taylorinalaska/TeensyPoly6-T4.1/photos/synthlabeled.jpg

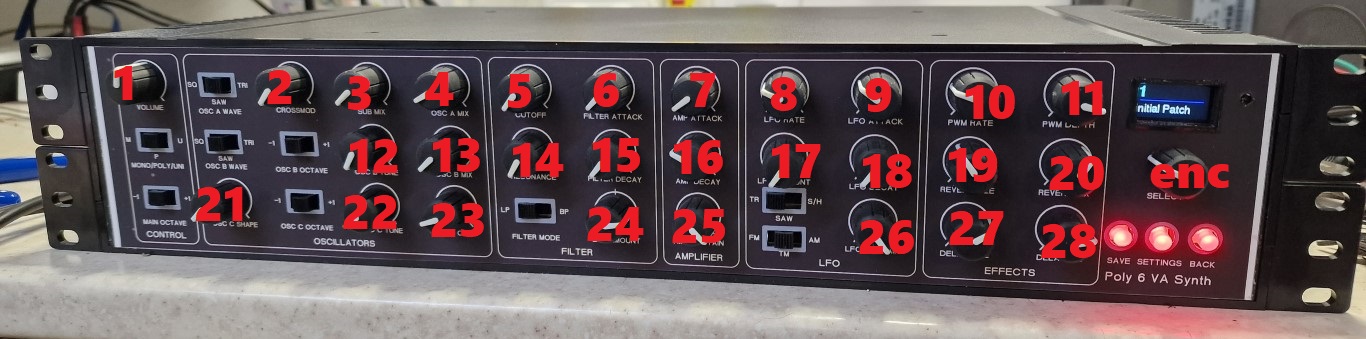
photos/synthlabeled.jpg
