taylorinalaska/TeensyPoly6-T4.1/TeensyPoly6_schematic41.pdf

1

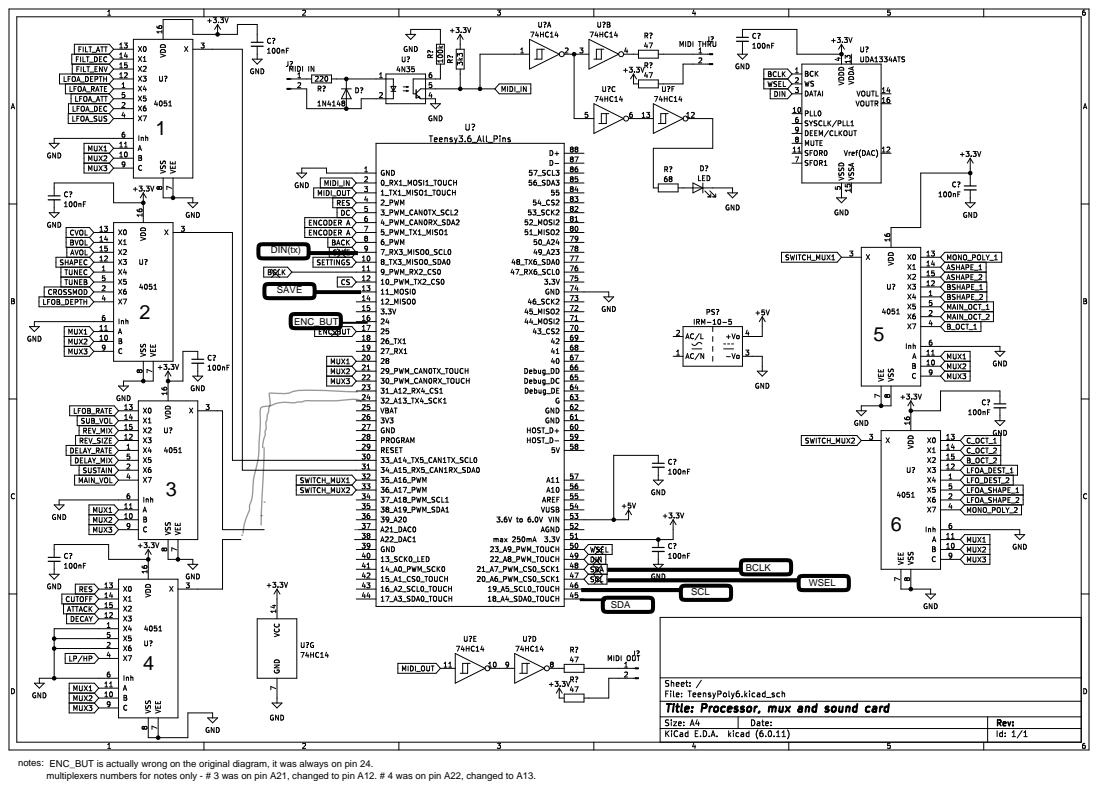
[picture p3: page 1]
ENC_BUT; SDA; SCL; BCLK; SAVE; DIN(tx); WSEL

notes: ENC_BUT is actually wrong on the original diagram, it was always on pin 24.
multiplexers numbers for notes only - # 3 was on pin A21, changed to pin A12. # 4 was on pin A22, changed to A13.
