taylorinalaska/TeensyPoly6-T4.1/tempschematic.pdf

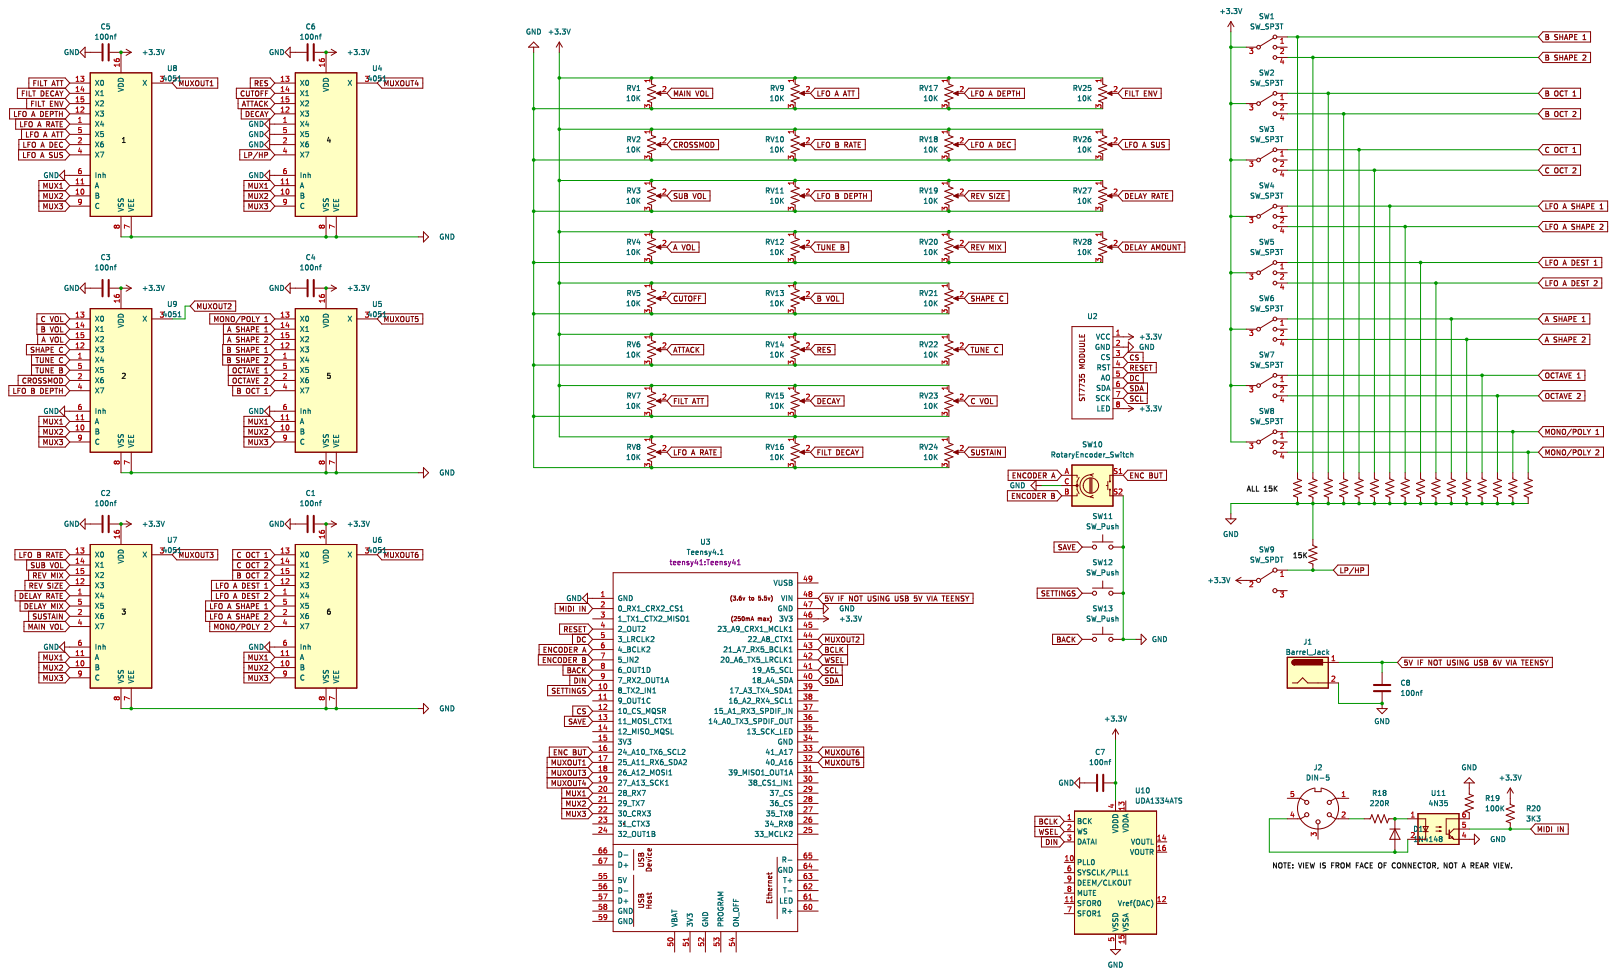
[picture p4: page 1]
