taylorinalaska/TeensyPoly6-T4.1/TeensyPoly6-frontpanel_schematic.pdf

7

16

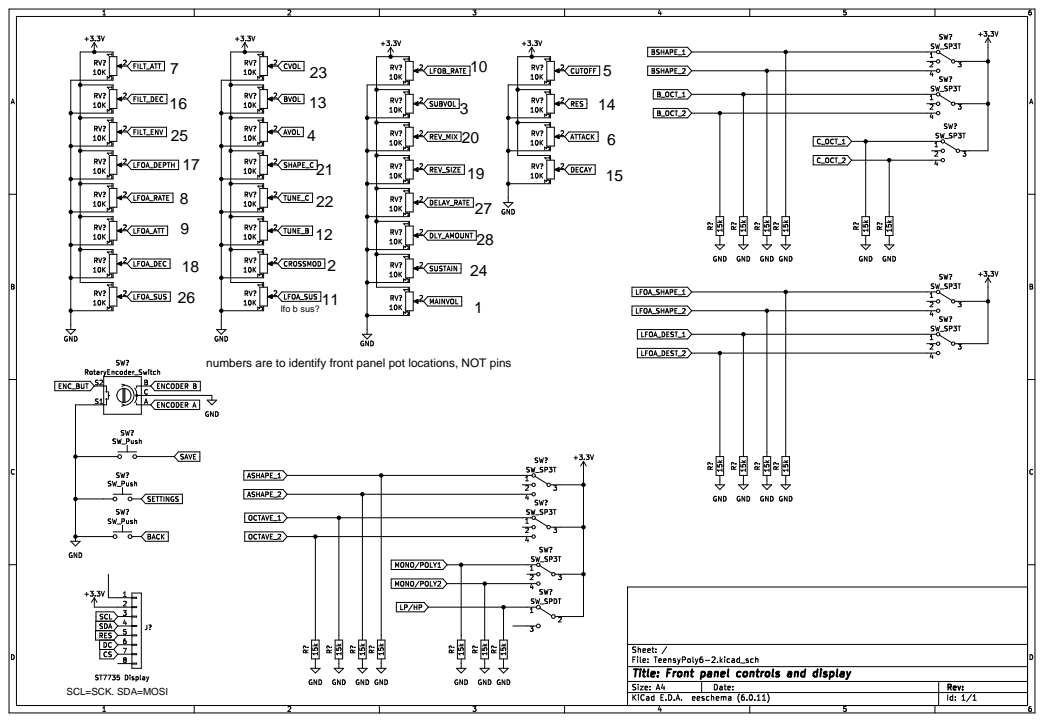
[picture p5: page 1]
lfo b sus?

numbers are to identify front panel pot locations, NOT pins

SCL=SCK. SDA=MOSI
