taylorinalaska/TeensyPoly6-T4.1/TeensyPoly6/Parameters.h

//Values below are just for initialising and will be changed when synth is initialised to current panel controls & EEPROM settings
byte midiChannel = 1;

byte pitchBendRange;
byte modWheelDepth;
byte afterTouchDepth;
byte NP;

byte ccChannel = midiChannel;
byte midiOutCh = midiChannel;
boolean patchRecall = false;

const int muxPots1 = A11;       //25
const int muxPots2 = A8;       //22
const int muxPots3 = A12;     //26    //WAS A21, 4.1 DOESNT HAVE THIS PIN
const int muxPots4 = A13;    //27    //WAS A22, 4.1 DOESNT HAVE THIS PIN
const int muxPots5 = A16;   //40
const int muxPots6 = A17;  //41

#define TOLERANCE 3

int MIDIThru = midi::Thru::Off;  //(EEPROM)
String patchName = INITPATCHNAME;
boolean encCW = true;  //This is to set the encoder to increment when turned CW - Settings Option

int midiModAmount = 0;
int returnvalue = 0;

boolean pickUp = true;  //settings option (EEPROM)
boolean pickUpActive = false;
boolean modAmount = false;
boolean saveMagicPatch = false;
boolean addingPatch = false;
boolean oldpickUpActive;
boolean Program = false;


// GUItool: begin automatically generated code
AudioSynthWaveform lfoA1;           //xy=153.9333610534668,214.64774894714355
AudioSynthWaveform lfoA2;           //xy=159.33330154418945,472.5476875305176
AudioSynthWaveform lfoA3;           //xy=161.90474319458008,732.6191596984863
AudioSynthWaveform lfoA4;           //xy=161.90474319458008,992.7619819641113
AudioSynthWaveform lfoA5;           //xy=167.30468368530273,1242.6619205474854
AudioSynthWaveform lfoA6;           //xy=169.87612533569336,1512.733392715454
AudioEffectEnvelope lfoAenv1;       //xy=232.33330917358398,129.3143424987793
AudioSynthWaveform lfoB1;           //xy=278.9333305358887,173.93335914611816
AudioEffectEnvelope lfoAenv2;       //xy=279.3332748413086,472.5476369857788
AudioEffectEnvelope lfoAenv3;       //xy=281.9047164916992,732.6191091537476
AudioEffectEnvelope lfoAenv4;       //xy=281.9047164916992,992.7619314193726
AudioSynthWaveform lfoB2;           //xy=284.3332710266113,431.8332977294922
AudioSynthWaveform lfoB3;           //xy=286.90471267700195,691.9047698974609
AudioSynthWaveform lfoB4;           //xy=286.90471267700195,952.0475921630859
AudioEffectEnvelope lfoAenv5;       //xy=287.3046569824219,1242.6618700027466
AudioEffectEnvelope lfoAenv6;       //xy=289.8760986328125,1512.7333421707153
AudioSynthWaveform lfoB5;           //xy=292.3046531677246,1201.94753074646
AudioSynthWaveform lfoB6;           //xy=294.87609481811523,1472.0190029144287
AudioMixer4 modMix1;                //xy=315.8000030517578,97.93336296081543
AudioAnalyzeRMS lfoAread1;          //xy=320.53334045410156,248.9333620071411
AudioMixer4 modMix2;                //xy=321.19994354248047,355.83330154418945
AudioMixer4 modMix3;                //xy=323.7713851928711,615.9047737121582
AudioMixer4 modMix4;                //xy=323.7713851928711,876.0475959777832
AudioMixer4 modMix5;                //xy=329.17132568359375,1125.9475345611572
AudioMixer4 modMix6;                //xy=331.7427673339844,1396.019006729126
AudioSynthWaveformModulated sub1;   //xy=470.93334197998047,208.93334197998047
AudioSynthWaveformModulated vcoA1;  //xy=471.93334197998047,115.9333381652832
AudioSynthWaveformModulated vcoB1;  //xy=471.93334197998047,146.93334770202637
AudioSynthWaveformModulated vcoC1;  //xy=471.9333724975586,177.93337440490723
AudioSynthWaveformModulated sub2;   //xy=476.3332824707031,466.8332805633545
AudioSynthWaveformModulated vcoA2;  //xy=477.3332824707031,373.8332767486572
AudioSynthWaveformModulated vcoB2;  //xy=477.3332824707031,404.8332862854004
AudioSynthWaveformModulated vcoC2;  //xy=477.33331298828125,435.83331298828125
AudioSynthWaveformModulated sub3;   //xy=478.90472412109375,726.9047527313232
AudioSynthWaveformModulated vcoA3;  //xy=479.90472412109375,633.904748916626
AudioSynthWaveformModulated vcoB3;  //xy=479.90472412109375,664.9047584533691
AudioSynthWaveformModulated vcoC3;  //xy=479.9047546386719,695.90478515625
AudioSynthWaveformModulated sub4;   //xy=478.90472412109375,987.0475749969482
AudioSynthWaveformModulated vcoA4;  //xy=479.90472412109375,894.047571182251
AudioSynthWaveformModulated vcoB4;  //xy=479.90472412109375,925.0475807189941
AudioSynthWaveformModulated vcoC4;  //xy=479.9047546386719,956.047607421875
AudioSynthWaveformModulated sub5;   //xy=484.3046646118164,1236.9475135803223
AudioSynthWaveformModulated vcoA5;  //xy=485.3046646118164,1143.947509765625
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
AudioConnection patchCord48(lfoB6, 0, vcoA6, 1);
AudioConnection patchCord49(lfoB6, 0, vcoB6, 1);
AudioConnection patchCord50(modMix1, 0, vcoA1, 0);
AudioConnection patchCord51(modMix2, 0, vcoA2, 0);
AudioConnection patchCord52(modMix3, 0, vcoA3, 0);
AudioConnection patchCord53(modMix4, 0, vcoA4, 0);
AudioConnection patchCord54(modMix5, 0, vcoA5, 0);
AudioConnection patchCord55(modMix6, 0, vcoA6, 0);
AudioConnection patchCord56(sub1, 0, voiceMix1, 3);
AudioConnection patchCord57(vcoA1, 0, voiceMix1, 0);
AudioConnection patchCord58(vcoB1, 0, voiceMix1, 1);
AudioConnection patchCord59(vcoB1, 0, modMix1, 0);
AudioConnection patchCord60(vcoC1, 0, voiceMix1, 2);
AudioConnection patchCord61(sub2, 0, voiceMix2, 3);
AudioConnection patchCord62(vcoA2, 0, voiceMix2, 0);
AudioConnection patchCord63(vcoB2, 0, voiceMix2, 1);
AudioConnection patchCord64(vcoB2, 0, modMix2, 0);
AudioConnection patchCord65(vcoC2, 0, voiceMix2, 2);
AudioConnection patchCord66(sub3, 0, voiceMix3, 3);
AudioConnection patchCord67(vcoA3, 0, voiceMix3, 0);
AudioConnection patchCord68(vcoB3, 0, voiceMix3, 1);
AudioConnection patchCord69(vcoB3, 0, modMix3, 0);
AudioConnection patchCord70(vcoC3, 0, voiceMix3, 2);
AudioConnection patchCord71(sub4, 0, voiceMix4, 3);
AudioConnection patchCord72(vcoA4, 0, voiceMix4, 0);
AudioConnection patchCord73(vcoB4, 0, voiceMix4, 1);
AudioConnection patchCord74(vcoB4, 0, modMix4, 0);
AudioConnection patchCord75(vcoC4, 0, voiceMix4, 2);
AudioConnection patchCord76(sub5, 0, voiceMix5, 3);
AudioConnection patchCord77(vcoA5, 0, voiceMix5, 0);
AudioConnection patchCord78(vcoB5, 0, voiceMix5, 1);
AudioConnection patchCord79(vcoB5, 0, modMix5, 0);
AudioConnection patchCord80(vcoC5, 0, voiceMix5, 2);
AudioConnection patchCord81(sub6, 0, voiceMix6, 3);
AudioConnection patchCord82(vcoA6, 0, voiceMix6, 0);
AudioConnection patchCord83(vcoB6, 0, voiceMix6, 1);
AudioConnection patchCord84(vcoB6, 0, modMix6, 0);
AudioConnection patchCord85(vcoC6, 0, voiceMix6, 2);
AudioConnection patchCord86(voiceMix1, 0, filter1, 0);
AudioConnection patchCord87(voiceMix2, 0, filter2, 0);
AudioConnection patchCord88(voiceMix3, 0, filter3, 0);
AudioConnection patchCord89(voiceMix4, 0, filter4, 0);
AudioConnection patchCord90(voiceMix5, 0, filter5, 0);
AudioConnection patchCord91(voiceMix6, 0, filter6, 0);
AudioConnection patchCord92(dc1, filterEnv1);
AudioConnection patchCord93(dc2, filterEnv2);
AudioConnection patchCord94(dc3, filterEnv3);
AudioConnection patchCord95(dc4, filterEnv4);
AudioConnection patchCord96(dc5, filterEnv5);
AudioConnection patchCord97(dc6, filterEnv6);
AudioConnection patchCord98(filterEnv1, 0, filterMix1, 0);
AudioConnection patchCord99(filterEnv2, 0, filterMix2, 0);
AudioConnection patchCord100(filterEnv3, 0, filterMix3, 0);
AudioConnection patchCord101(filterEnv4, 0, filterMix4, 0);
AudioConnection patchCord102(filterEnv5, 0, filterMix5, 0);
AudioConnection patchCord103(filterEnv6, 0, filterMix6, 0);
AudioConnection patchCord104(filterMix1, 0, filter1, 1);
AudioConnection patchCord105(filterMix2, 0, filter2, 1);
AudioConnection patchCord106(filterMix3, 0, filter3, 1);
AudioConnection patchCord107(filterMix4, 0, filter4, 1);
AudioConnection patchCord108(filterMix5, 0, filter5, 1);
AudioConnection patchCord109(filterMix6, 0, filter6, 1);
AudioConnection patchCord110(filter1, 0, filterMode1, 0);
AudioConnection patchCord111(filter1, 1, filterMode1, 1);
AudioConnection patchCord112(filter2, 0, filterMode2, 0);
AudioConnection patchCord113(filter2, 1, filterMode2, 1);
AudioConnection patchCord114(filter3, 0, filterMode3, 0);
AudioConnection patchCord115(filter3, 1, filterMode3, 1);
AudioConnection patchCord116(filter4, 0, filterMode4, 0);
AudioConnection patchCord117(filter4, 1, filterMode4, 1);
AudioConnection patchCord118(filter5, 0, filterMode5, 0);
AudioConnection patchCord119(filter5, 1, filterMode5, 1);
AudioConnection patchCord120(filter6, 0, filterMode6, 0);
AudioConnection patchCord121(filter6, 1, filterMode6, 1);
AudioConnection patchCord122(filterMode1, env1);
AudioConnection patchCord123(filterMode2, env2);
AudioConnection patchCord124(filterMode3, env3);
AudioConnection patchCord125(filterMode4, env4);
AudioConnection patchCord126(filterMode5, env5);
AudioConnection patchCord127(filterMode6, env6);
AudioConnection patchCord128(env1, 0, mix1, 0);
AudioConnection patchCord129(env2, 0, mix1, 1);
AudioConnection patchCord130(env3, 0, mix1, 2);
AudioConnection patchCord131(env4, 0, mix2, 0);
AudioConnection patchCord132(env5, 0, mix2, 1);
AudioConnection patchCord133(env6, 0, mix2, 2);
AudioConnection patchCord134(mix1, 0, finalMix, 0);
AudioConnection patchCord135(mix2, 0, finalMix, 1);
AudioConnection patchCord136(finalMix, 0, fxL, 0);
AudioConnection patchCord137(finalMix, reverb);
AudioConnection patchCord138(finalMix, 0, fxR, 0);
AudioConnection patchCord139(finalMix, 0, dlyMixL, 0);
AudioConnection patchCord140(finalMix, 0, dlyMixR, 0);
AudioConnection patchCord141(dlyFiltR, 0, dlyMixR, 1);
AudioConnection patchCord142(dlyFiltL, 0, dlyMixL, 1);
AudioConnection patchCord143(dlyL, 0, dlyFiltL, 0);
AudioConnection patchCord144(dlyR, 0, dlyFiltR, 0);
AudioConnection patchCord145(dlyMixR, 0, fxR, 2);
AudioConnection patchCord146(dlyMixR, dlyR);
AudioConnection patchCord147(dlyMixL, 0, fxL, 2);
AudioConnection patchCord148(dlyMixL, dlyL);
AudioConnection patchCord149(reverb, 0, fxL, 1);
AudioConnection patchCord150(reverb, 0, fxR, 1);
AudioConnection patchCord151(fxL, 0, i2s1, 0);
AudioConnection patchCord152(fxR, 0, i2s1, 1);
// GUItool: end automatically generated code

int midiMod = 0;

float newpitchbend = 0;



///// notes, frequencies, voices /////////////////////////////////////////////////////////////////////////
///////////////////////////////////////////////////////////////////////////////////////////////////////////
const float noteFreqs[128] = { 8.176, 8.662, 9.177, 9.723, 10.301, 10.913, 11.562, 12.25, 12.978, 13.75, 14.568, 15.434, 16.352, 17.324, 18.354, 19.445, 20.602, 21.827, 23.125, 24.5, 25.957, 27.5, 29.135, 30.868, 32.703, 34.648, 36.708, 38.891, 41.203, 43.654, 46.249, 48.999, 51.913, 55, 58.27, 61.735, 65.406, 69.296, 73.416, 77.782, 82.407, 87.307, 92.499, 97.999, 103.826, 110, 116.541, 123.471, 130.813, 138.591, 146.832, 155.563, 164.814, 174.614, 184.997, 195.998, 207.652, 220, 233.082, 246.942, 261.626, 277.183, 293.665, 311.127, 329.628, 349.228, 369.994, 391.995, 415.305, 440, 466.164, 493.883, 523.251, 554.365, 587.33, 622.254, 659.255, 698.456, 739.989, 783.991, 830.609, 880, 932.328, 987.767, 1046.502, 1108.731, 1174.659, 1244.508, 1318.51, 1396.913, 1479.978, 1567.982, 1661.219, 1760, 1864.655, 1975.533, 2093.005, 2217.461, 2349.318, 2489.016, 2637.02, 2793.826, 2959.955, 3135.963, 3322.438, 3520, 3729.31, 3951.066, 4186.009, 4434.922, 4698.636, 4978.032, 5274.041, 5587.652, 5919.911, 6271.927, 6644.875, 7040, 7458.62, 7902.133, 8372.018, 8869.844, 9397.273, 9956.063, 10548.08, 11175.3, 11839.82, 12543.85 };

int note1freq;
int note2freq;
int note3freq;
int note4freq;
int note5freq;
int note6freq;

//int voices;


//checks if notes are on or not
///////////////////////////////////////////////////////////////////////////////////////////////////////////
bool env1on = false;
bool env2on = false;
bool env3on = false;
bool env4on = false;
bool env5on = false;
bool env6on = false;

//int vol of vcos.
float vcoVol = 0.07;
float mainVol;




float bend = 1.00;

//voice mixer
///////////////////////////////////////////////////////////////////////////////////////////////////////////
float vcoAvol = 0.5;
float vcoBvol = 0.5;
float vcoCvol = 0.5;
float Subvol = 0.5;

float crossMod;

//Tunings, octaves etc.
///////////////////////////////////////////////////////////////////////////////////////////////////////////
float octave = 1;
float octaveB = 1;
float octaveC = 1;
float tuneB = 1;
float tuneC = 1;
byte unidetune = 0;
byte oldunidetune = 0;
float detune = 1.000;
float olddetune = 1.000;

//vco shapes
int shapeA;
int shapeB;
int shapeC = 1;


//filter
///////////////////////////////////////////////////////////////////////////////////////////////////////////
int cut = 2000;
float res = 1;
int filtAtt;
int filtDec;
float filtAmt;

int filterMode;


//envelope
///////////////////////////////////////////////////////////////////////////////////////////////////////////
int envAtt;
int envDec;
int envRel;
float envSus;

//lfo A
///////////////////////////////////////////////////////////////////////////////////////////////////////////
float lfoAamp;
float lfoAfreq;
int lfoAdel;
int lfoAatt;
int lfoAdec;
int lfoArel;
float lfoAsus;

int lfoAshape;
int lfoAdest;


//tremolo
float ampMod;
float readInt = 1.0001;
unsigned long prevTime;


//lfo B
///////////////////////////////////////////////////////////////////////////////////////////////////////////
float lfoBamp;
float lfoBfreq;



//delay
///////////////////////////////////////////////////////////////////////////////////////////////////////////
float outGain = 0.8;
float dlyAmt;

float dlyTimeL;
float dlyTimeR;

//reverb
///////////////////////////////////////////////////////////////////////////////////////////////////////////
float revMix;
float revSize;






int timer = 6;
unsigned long prevTimer;

//28 WAVEFORMS
///////////////////////////////////////////////////////////////////////////////////////////////////////////
const int16_t wave1[257] = {
  652, 3250, 5203, 6105, 7141, 8326, 9440, 11564, 14886,
  17802, 20629, 24021, 27018, 27807, 27521, 26708, 25875, 25093, 25204,
  24485, 23202, 21859, 21177, 19946, 19560, 19924, 19937, 18705, 18559,
  20329, 22262, 23031, 22418, 22199, 22275, 24425, 25748, 28291, 27969,
  32767, 15117, -4838, -1354, -2955, -2067, -3567, -4453, -5371, -5142,
  -5939, -6755, -6863, -6361, -5851, -5767, -6034, -6776, -6129, -4368,
  -2801, -3522, -4762, -5516, -5567, -6764, -8322, -9493, -9451, -9420,
  -9843, -10963, -11722, -11960, -12028, -12463, -13045, -13706, -14132, -13916,
  -13653, -14082, -14822, -15241, -15832, -16372, -16585, -16913, -17330, -16569,
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
  -10980, -14740, -14054, -12594, -11932, -10353, -4662, -3012, -861, 1681,
  5670, 4756, 842, 8077, 11535, 9364, 3846, 1014, -4599, -10447,
  -12883, -14084, -14108, -12816, -9789, -10294, -10429, -10259, -10710, -4076,
  884, -4374, 3095, 14735, 14748, 14184, 21011, 18050, 12369, 12514,
  8700, 2259, -917, -2883, -7608, -10514, -17761, -8732, -2568, -5107,
  3690, 14548, 21436, 19765, 13104, 8092, 14228, 11506, 5493, 3373,
  -2490, -9373, -16230, -21230, -21709, -19469, -22672, -22119, -13095, -9569,
  -14186, -13037, -13322, -14860, -11388, -3982, -1002, 970
};
