taylorinalaska/TeensyPoly6-T4.1/TeensyPoly6/Constants.h

const char* VERSION = "V1.7";

#define RE_READ -9
#define  NO_OF_VOICES 6
#define NO_OF_PARAMS 48
const char* INITPATCHNAME = "Initial Patch";
#define HOLD_DURATION 1000
#define PATCHES_LIMIT 999
const uint32_t CLICK_DURATION = 250;
const String INITPATCH = "CC Mode,1,1,1,1,1,1,1,1,1,1,1,1,1,1,1,1,1,1,1,1,1,1,1,1,1,1,1,1,1,1,1,1,1,1,1,1,1,1,1,1,1,1,1,1,1,1,1,1,1,1,1,1,1,1,1,1,1,1,1,1,1,1,1,1,1,1,1,1,1,1,1,1,1,1,1,1,1,1,1,1,1,1,1,1,1,1,1,1,1,1,1,1,1,1,1,1,1,1,1,1,1,1,1,1,1,1,1,1,1,1,1,1,1,1,1,1,1,1,1";
