taylorinalaska/TeensyPoly6-T4.1/(commit log)

2023-04-12 Fixed to make it compile properly
    [TeensyPoly6-main.ino]
2023-04-13 Fixed MUX and poly mode
    [TeensyPoly6-main.ino]
2023-04-13 Fixed MUX and poly assign
    [TeensyPoly6-main.ino]
2023-04-13 Updated schematic with 4x 4051 mux chips and switches etc
2023-04-14 Added Mono/Poly/Unison Switch
2023-04-14 Added encoder and display
2023-04-19 Total rebuild with a T3.6 and bigger mux and Settings
    Added two more 4051 chips to the mux and removed all the direct digital input switches from the Teensy to the MUX.
    Upgraded to a T3.6 as the 3.5 was holding notes, not enough grunt and the settings menu was inoperable.
2023-04-21 Added PB range Off, 1-12 semitones
    The pitchbend range was 2 semitones and fixed, I changed it to Off, 1, 2. But I noticed that the tunings were slightly off, so I created a new maps for the PB ranges, doubling from 1.00 - 2.00 on the positive bend and 1.00 - 0.50 on the negative bend range. This fixed the accuracy of the bend ranges and allow me to implement 0-12 semitones.
    [Constants.h, TeensyPoly6-main.ino]
2023-07-29 Update TeensyPoly6-main.ino
    add serial printout to test midi note on
